rowantwilley16/Embedded-Game-Console-on-STM32/Code/Core/Src/main.c

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

/* Includes ------------------------------------------------------------------*/
#include "main.h"

/* USER CODE BEGIN PD */
#include "string.h"
#include <stdio.h>
#include <stdlib.h>
#include "UserGeneral.h"
/* USER CODE END PD */

ADC_HandleTypeDef hadc1;

I2C_HandleTypeDef hi2c1;

UART_HandleTypeDef huart2;

/* USER CODE BEGIN PV */

extern HAL_StatusTypeDef accRes;
extern HAL_StatusTypeDef accRes2;

extern uint8_t i2c_transferData[8];
extern uint8_t i2c_accData[8];

extern uint16_t i2cAddress ;
extern uint8_t ControlRegister1;
extern uint8_t ControlRegister1Data;
extern uint8_t outxl_reg ;
/* USER CODE END PV */

void SystemClock_Config(void);
static void MX_GPIO_Init(void);
static void MX_USART2_UART_Init(void);
static void MX_ADC1_Init(void);
static void MX_I2C1_Init(void);
/* USER CODE BEGIN 0 */
//void debugPrint(UART_HandleTypeDef *huart, char _out[]){
 //HAL_UART_Transmit( huart, (uint8_t *) _out, strlen(_out), 10);
//}
/* USER CODE END 0 */

/**
  * @brief  The application entry point.
  * @retval int
  */
int main(void)
{
  /* MCU Configuration--------------------------------------------------------*/

  /* Reset of all peripherals, Initializes the Flash interface and the Systick. */
  HAL_Init();

  /* Configure the system clock */
  SystemClock_Config();

  /* Initialize all configured peripherals */
  MX_GPIO_Init();
  MX_USART2_UART_Init();
  MX_ADC1_Init();
  MX_I2C1_Init();
  /* USER CODE BEGIN 2 */

  i2c_transferData[0] = ControlRegister1;
  i2c_transferData[1] = ControlRegister1Data;

  accRes = HAL_I2C_Master_Transmit(&hi2c1,i2cAddress,i2c_transferData, 2, 10);

 start();

  /* USER CODE END 2 */

  /* Infinite loop */
  /* USER CODE BEGIN WHILE */
  while (1)
  {
	  mainloop();
    /* USER CODE END WHILE */

    /* USER CODE BEGIN 3 */
  }
  /* USER CODE END 3 */
}

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
