rowantwilley16/Embedded-Game-Console-on-STM32/Code/Core/Inc/main.h

#define Debug_2_Pin GPIO_PIN_6
#define Debug_2_GPIO_Port GPIOA
#define Debug_3_Pin GPIO_PIN_7
#define Debug_3_GPIO_Port GPIOC
#define Debug_4_Pin GPIO_PIN_9
#define Debug_4_GPIO_Port GPIOA
#define Debug_1_Pin GPIO_PIN_9
#define Debug_1_GPIO_Port GPIOB
