rowantwilley16/Embedded-Game-Console-on-STM32/Code/Core/Inc/UserGeneral.h

/*
 * UserGeneral.h
 *
 *  Created on: Apr 12, 2021
 *      Author: Rowan
 */

#ifndef INC_USERGENERAL_H_
#define INC_USERGENERAL_H_

void start();
void mainloop();
void scanButton();
void updateScreen();
void calibrationSequence();
void mazeGameLoop();
void updatePosition();
void initialisePosition();
void updatePosition();
void test();
void clearScreen();
void exitGame();
void lightUpCorners();
void sampleSlider();
void sendCoordinatesUART();
void ButtonDebounce();

#endif /* INC_USERGENERAL_H_ */
