rowantwilley16/Embedded-Game-Console-on-STM32/Code/Core/Inc/mazeGame.h

/*
 * mazeGame.h
 *
 *  Created on: Apr 12, 2021
 *      Author: Rowan
 */

#ifndef INC_MAZEGAME_H_
#define INC_MAZEGAME_H_



#endif /* INC_MAZEGAME_H_ */


void mazeGameLoop();
void initialisePosition();
void updatePosition();
void clearScreen();
void updatePlayerPos();
void selectGame();
void state();
void sampleSlider();
void colomnScanMaze1();
void colomnScanMaze2();
void colomnScanMaze3();
void colomnScanMaze4();
void writeMazeToArray();
void resetElements();
void checkForExit();
void setBall();
void setEndGoal();
void sendMazeUART();
void MovePlayerIMU();
