rowantwilley16/Embedded-Game-Console-on-STM32/Code/Core/Inc/mazeGameSelect.h

/*
 * mazeGameSelect.h
 *
 *  Created on: 12 Jun 2021
 *      Author: Rowan
 */

#ifndef INC_MAZEGAMESELECT_H_
#define INC_MAZEGAMESELECT_H_


void mazeSelect();
void writeMaze1ToArray();
void writeMaze2ToArray();
void writeMaze3ToArray();
void writeMaze4ToArray();
void colomnScanNum1();
void colomnScanNum2();
void colomnScanNum3();
void colomnScanNum4();



#endif /* INC_MAZEGAMESELECT_H_ */
